erlendrm/LightBlu/Firmware/readme.txt

LDF1A_DK	- Bluetooth Smart Firmware for Kontrollmodul (nRF51 DK)
LDF1A_DONGLE	- Bluetooth Smart Firmware for Kontrollmodul (nRF51 Dongle)

LDFBIN1_MASTER	- Firmware for Switchmodul
LDFBIN1_SLAVE	- Firmware for Binaermodul

LDFDIM1_SLAVE	- Firmware for Dimmermodul
