erlendrm/LightBlu/Hardware/Utlegg/Binaermodul v.2.0.png

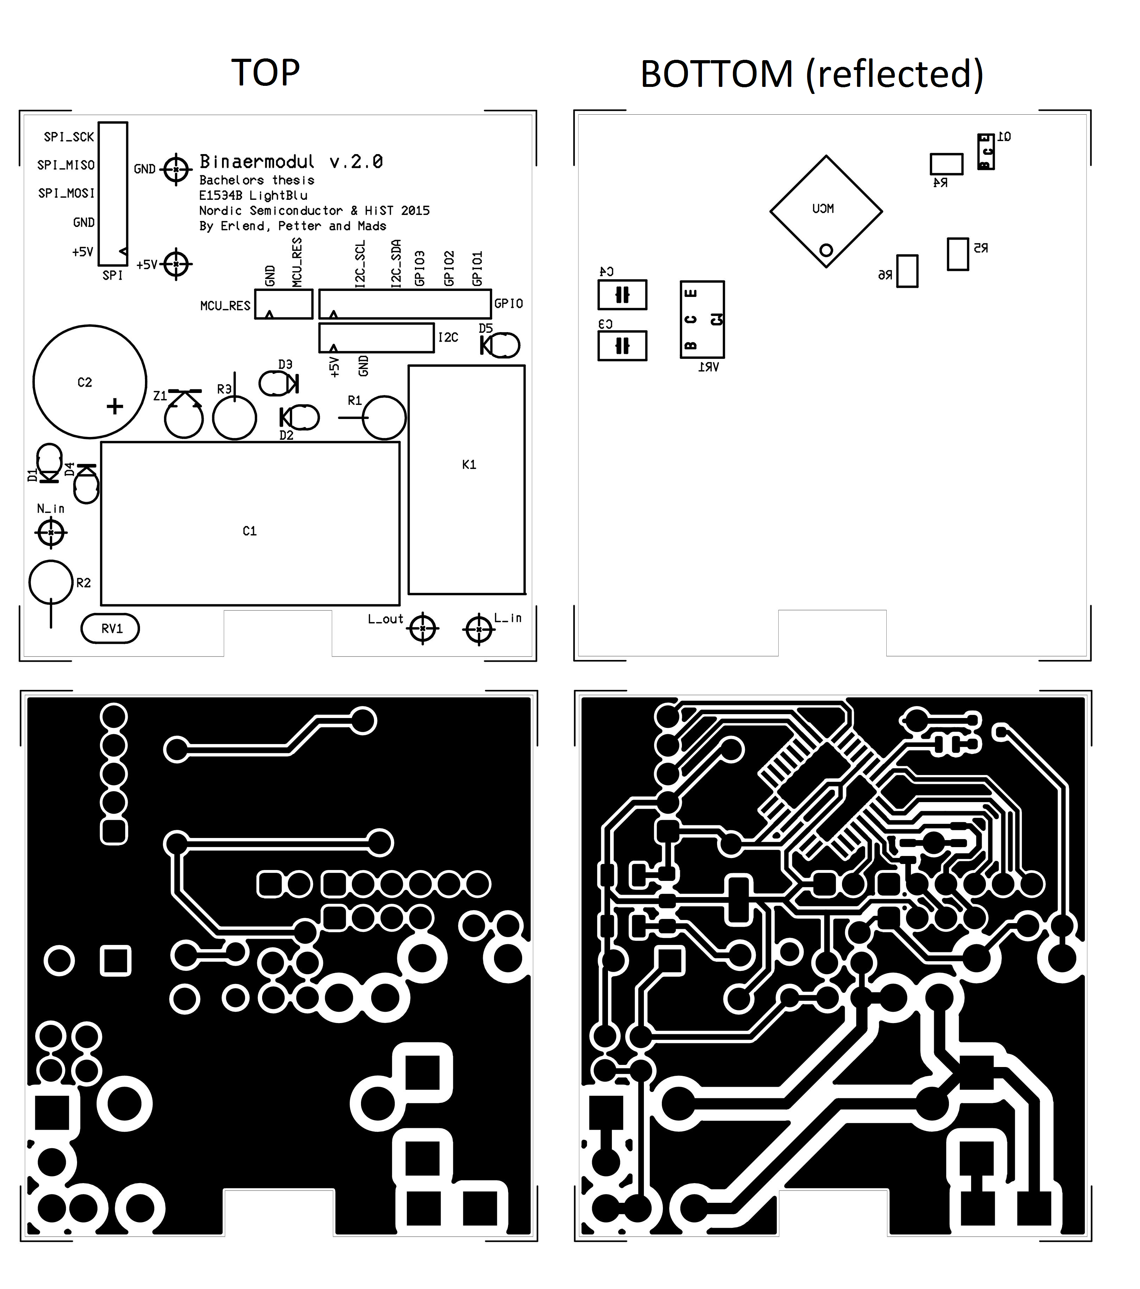
Hardware/Utlegg/Binaermodul v.2.0.png
