erlendrm/LightBlu/Hardware/Utlegg/Dimmermodul v.2.2.png

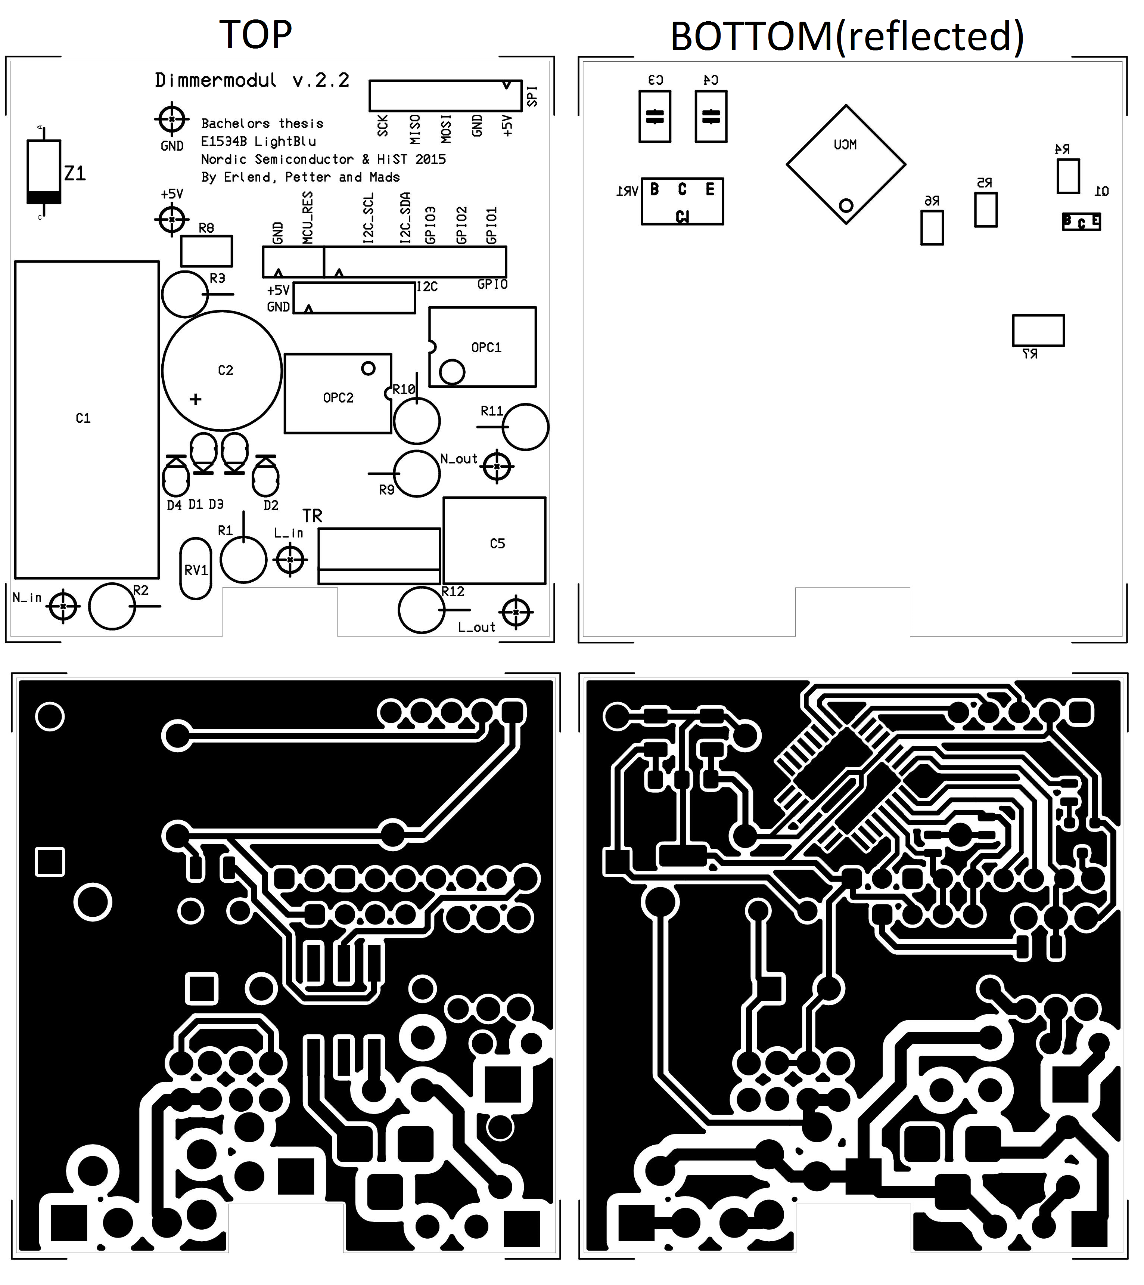
Hardware/Utlegg/Dimmermodul v.2.2.png
