erlendrm/LightBlu/Hardware/Skjemategninger/Binaermodul.pdf

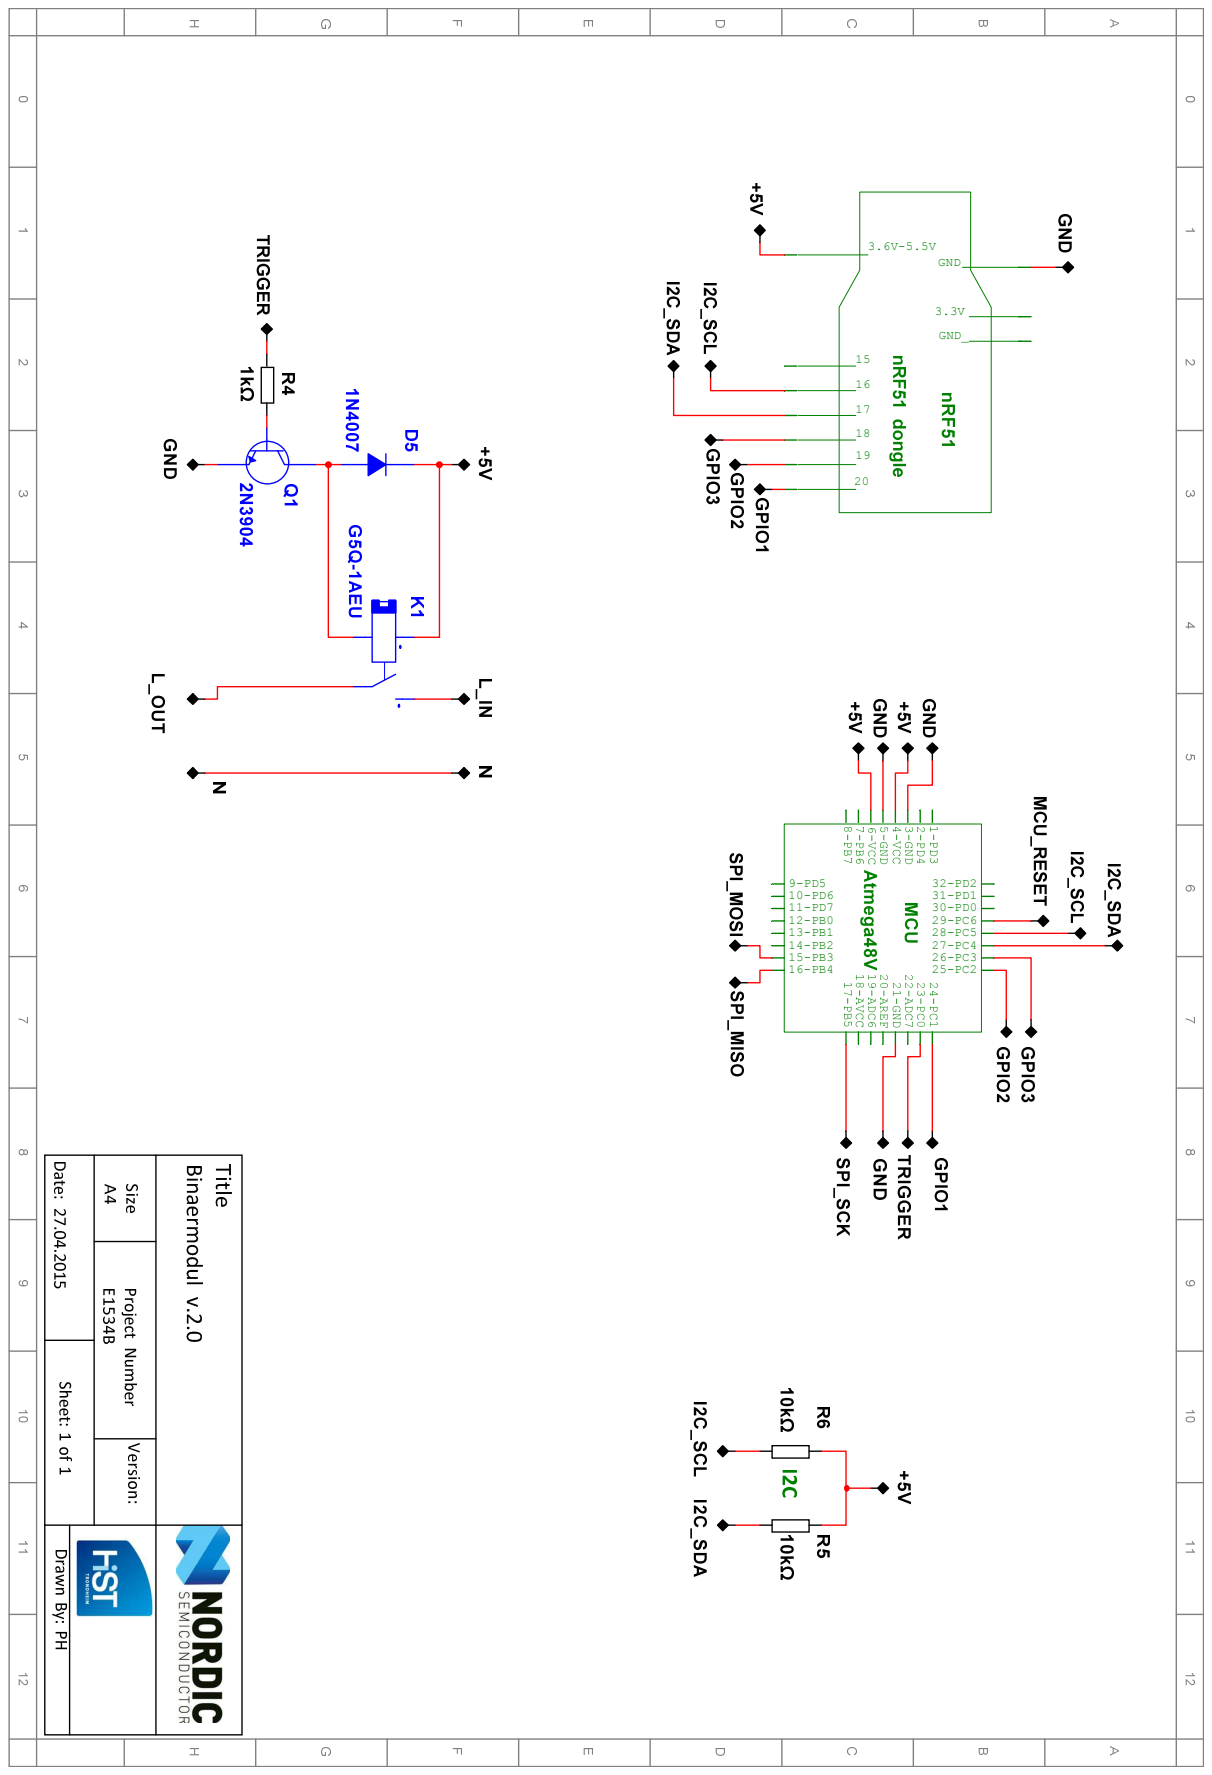
[picture p7: page 1]
GND; GND_
