erlendrm/LightBlu/Hardware/Skjemategninger/Dimmermod simplified.pdf

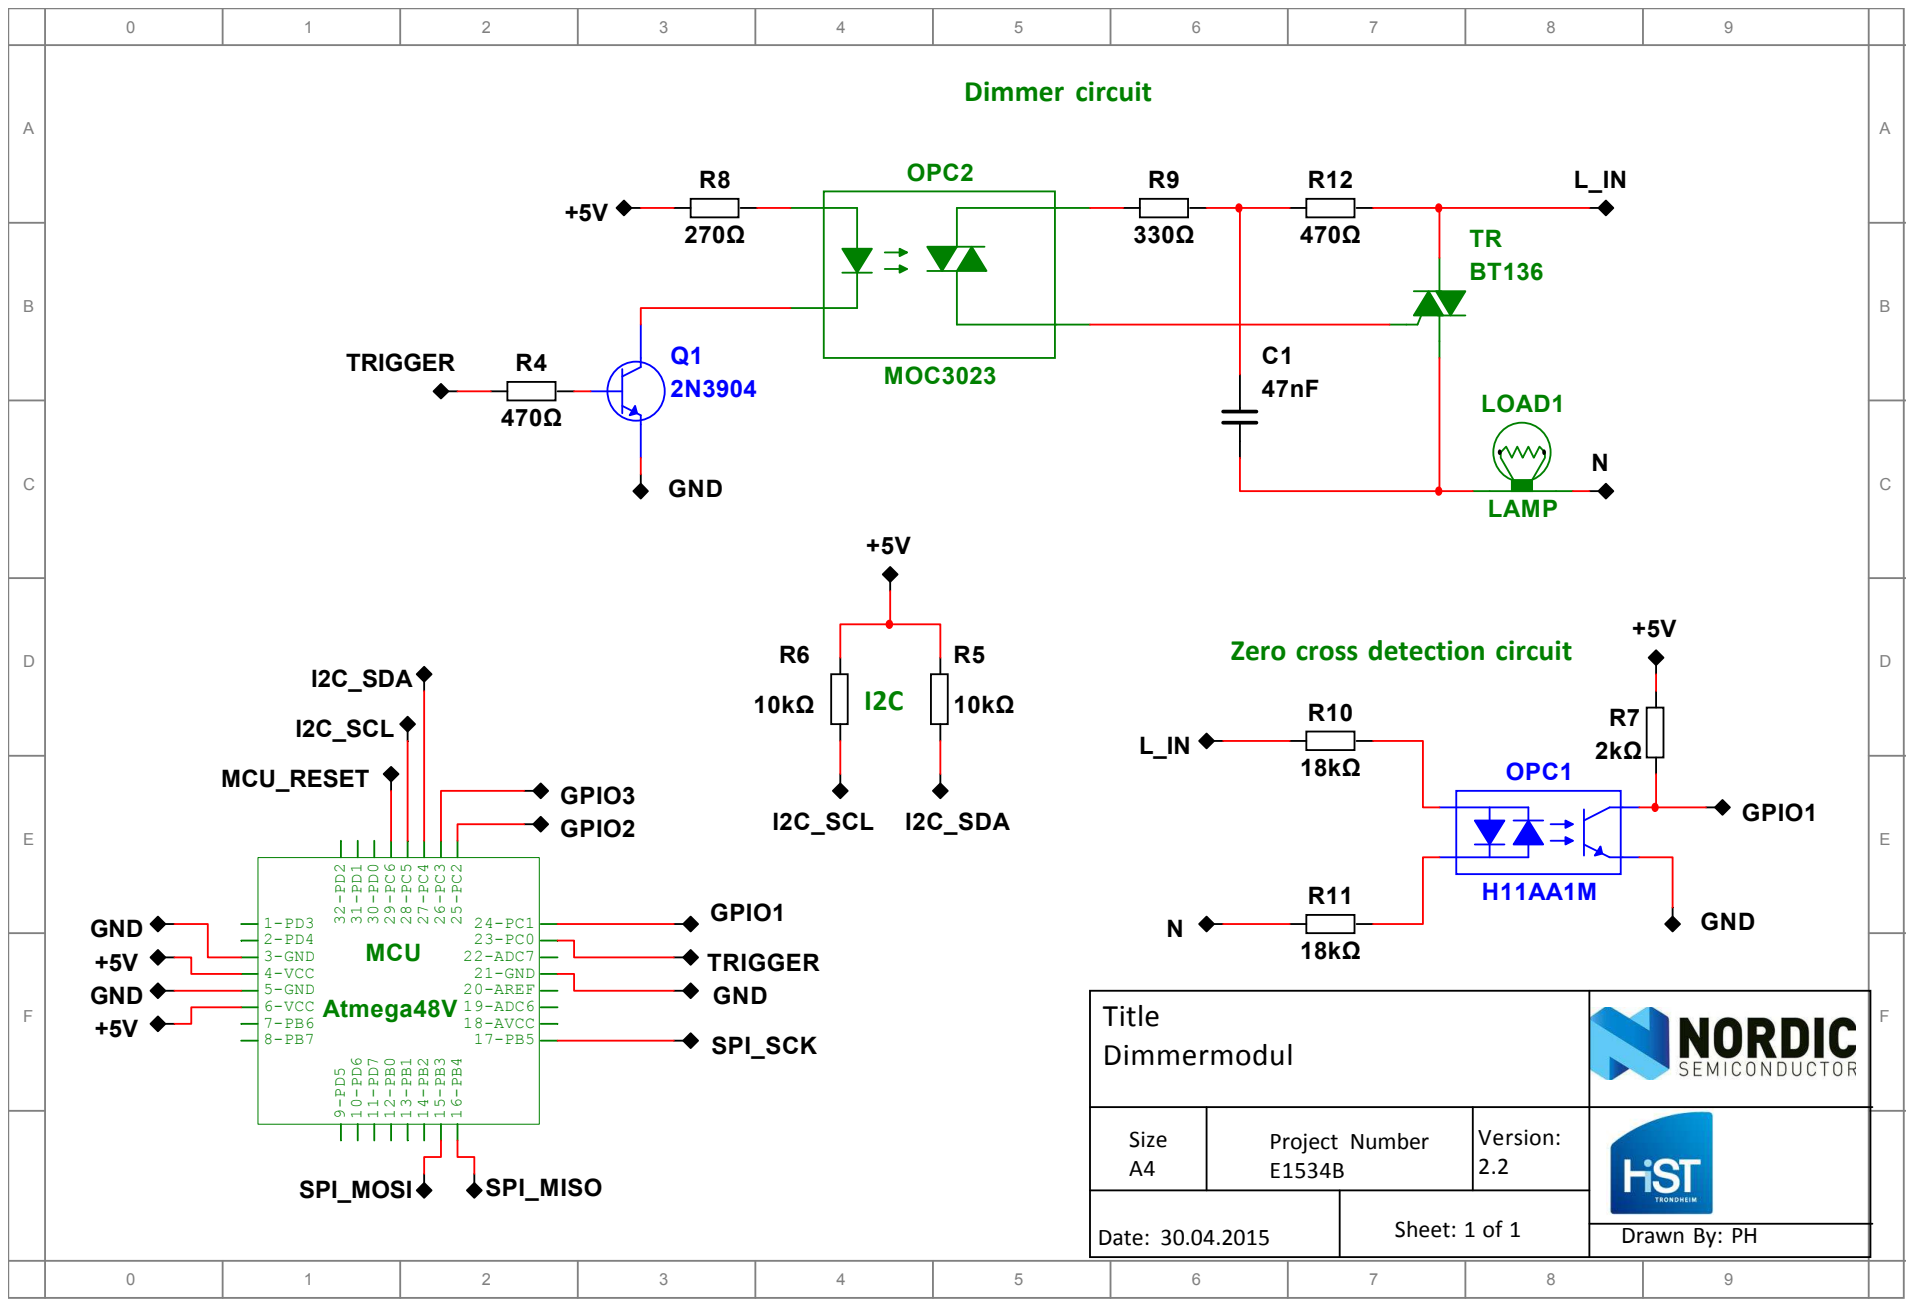
[picture p8: page 1]

Zero cross detection circuit
