erlendrm/LightBlu/Hardware/Skjemategninger/Dimmermodul.pdf

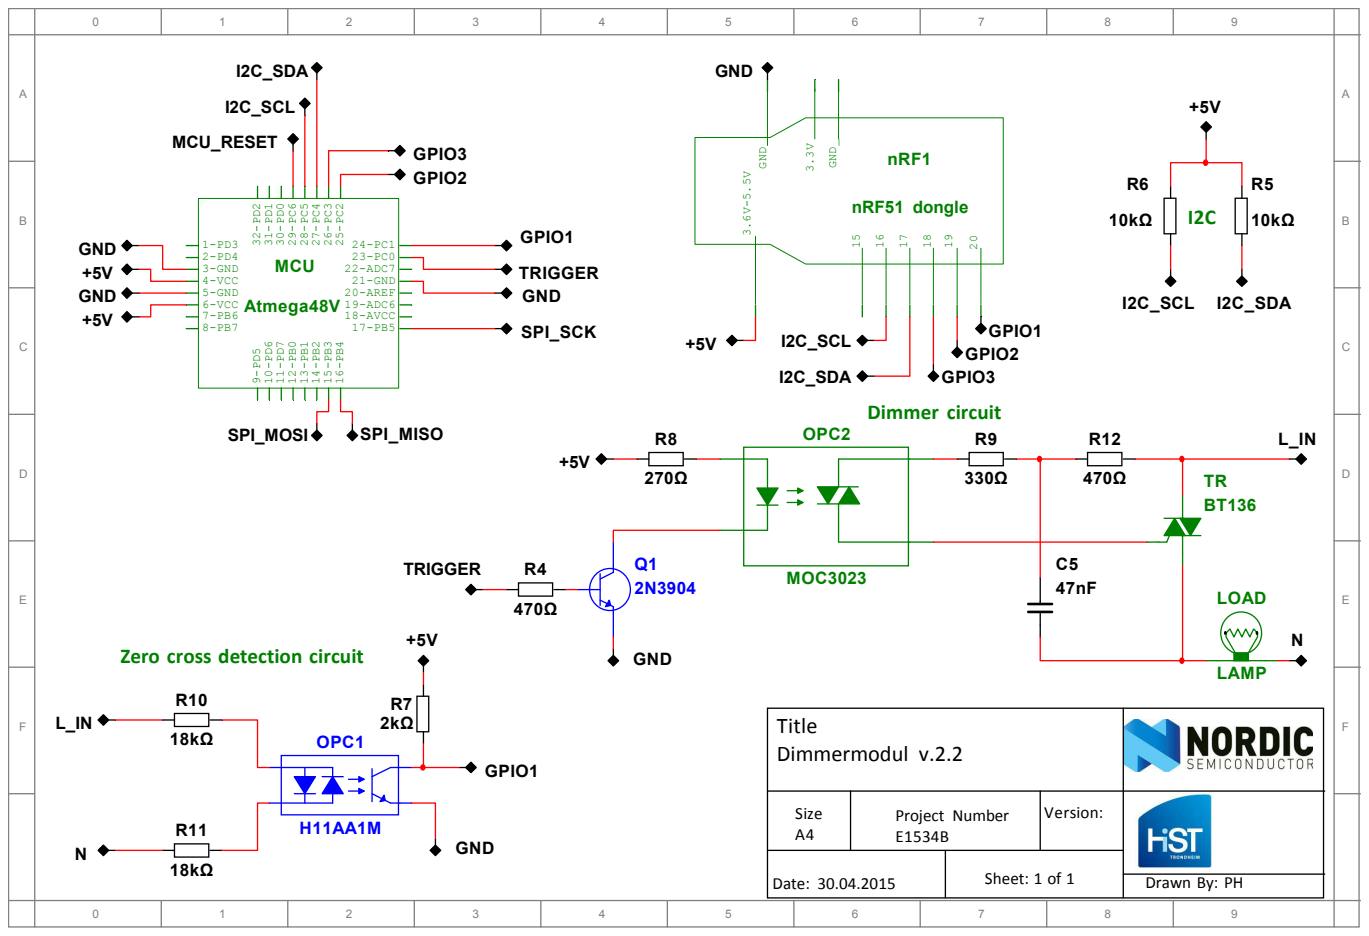
[picture p9: page 1]

Zero cross detection circuit
