erlendrm/LightBlu/Hardware/Skjemategninger/Binaermodul Simplified.pdf

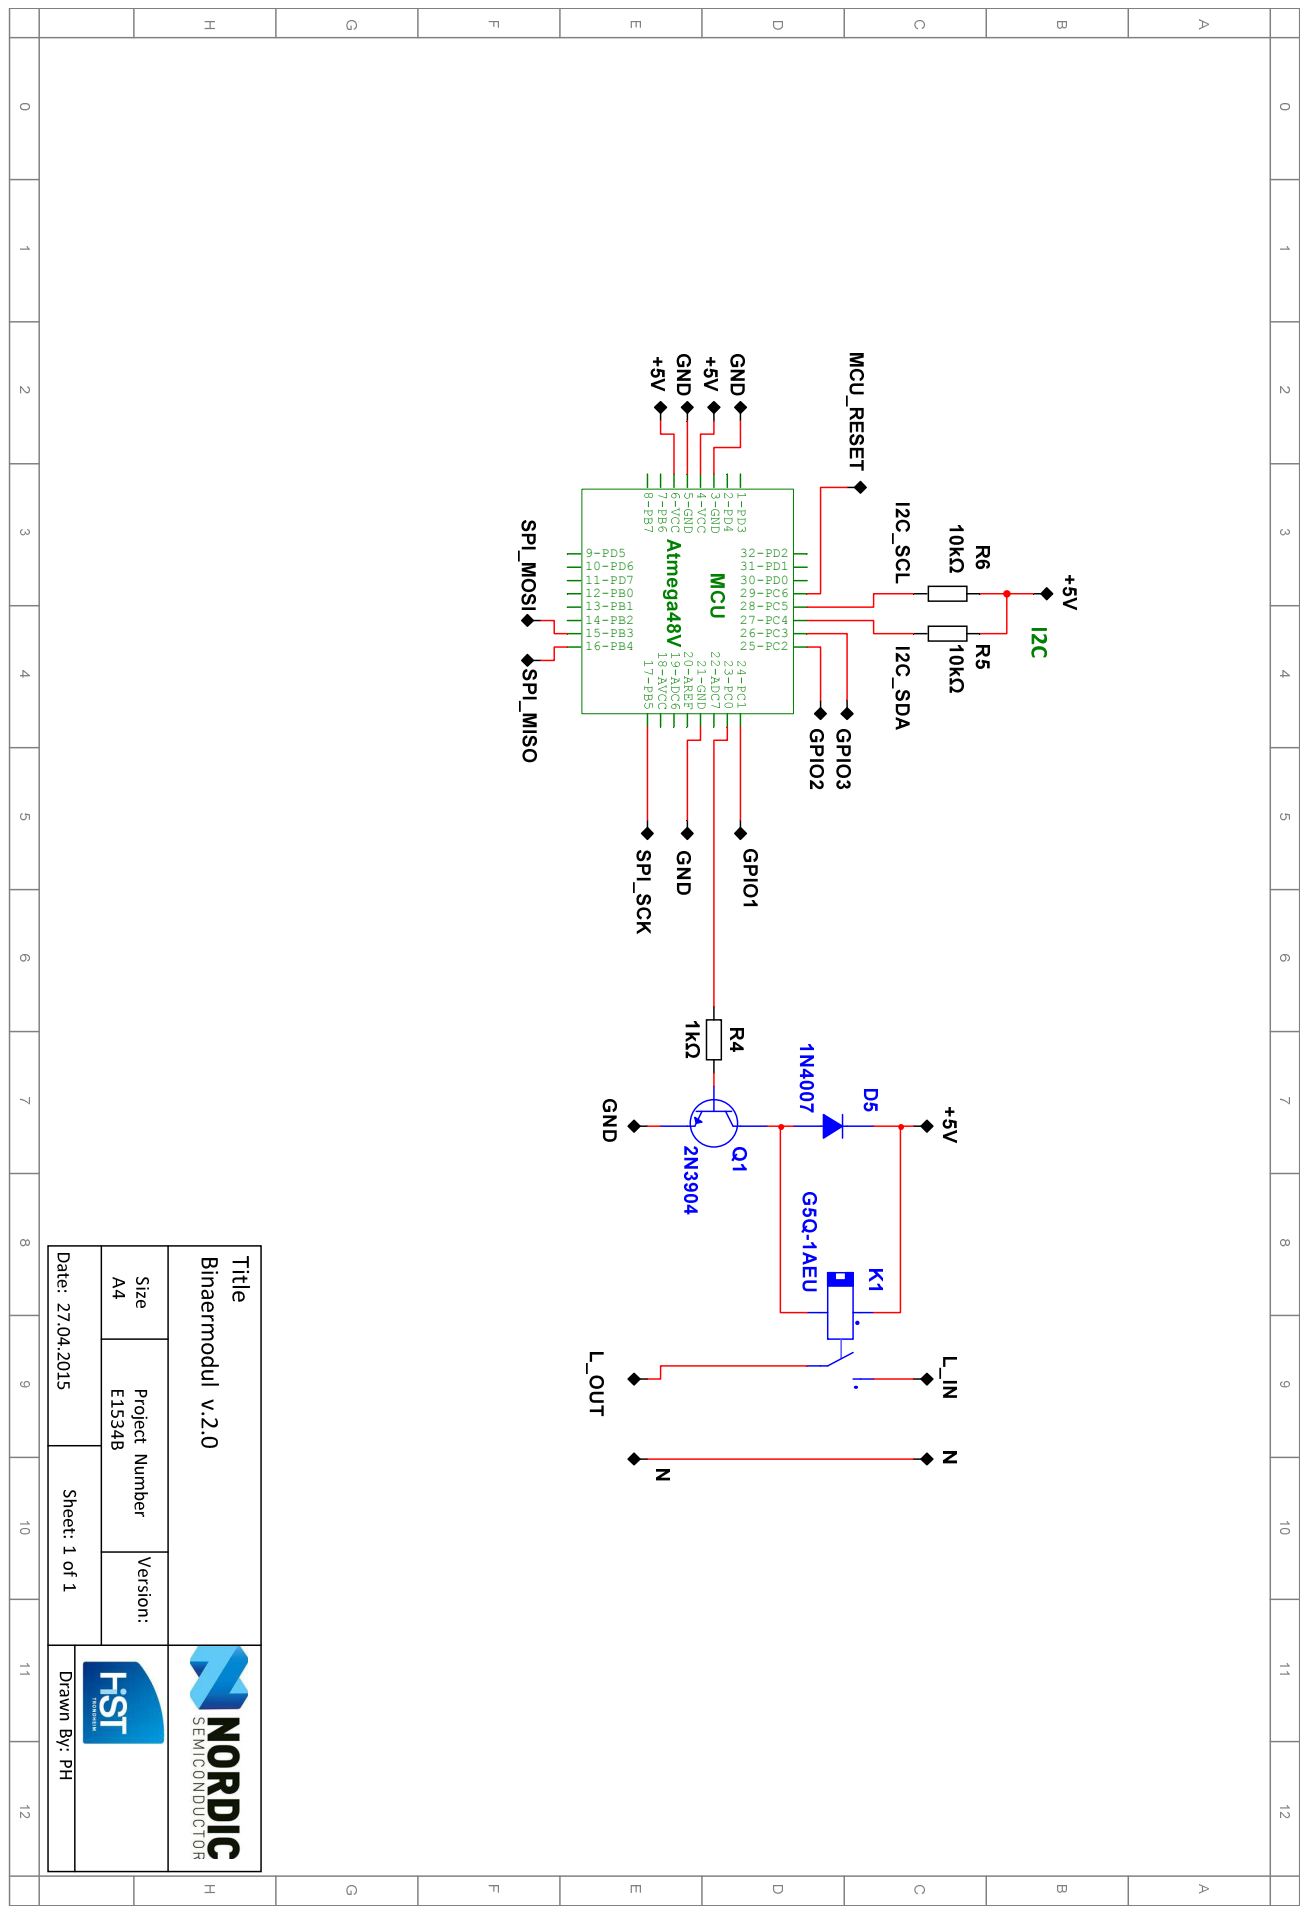
[picture p10: page 1]
