erlendrm/LightBlu/Hardware/Skjemategninger/VCC-Supply.pdf

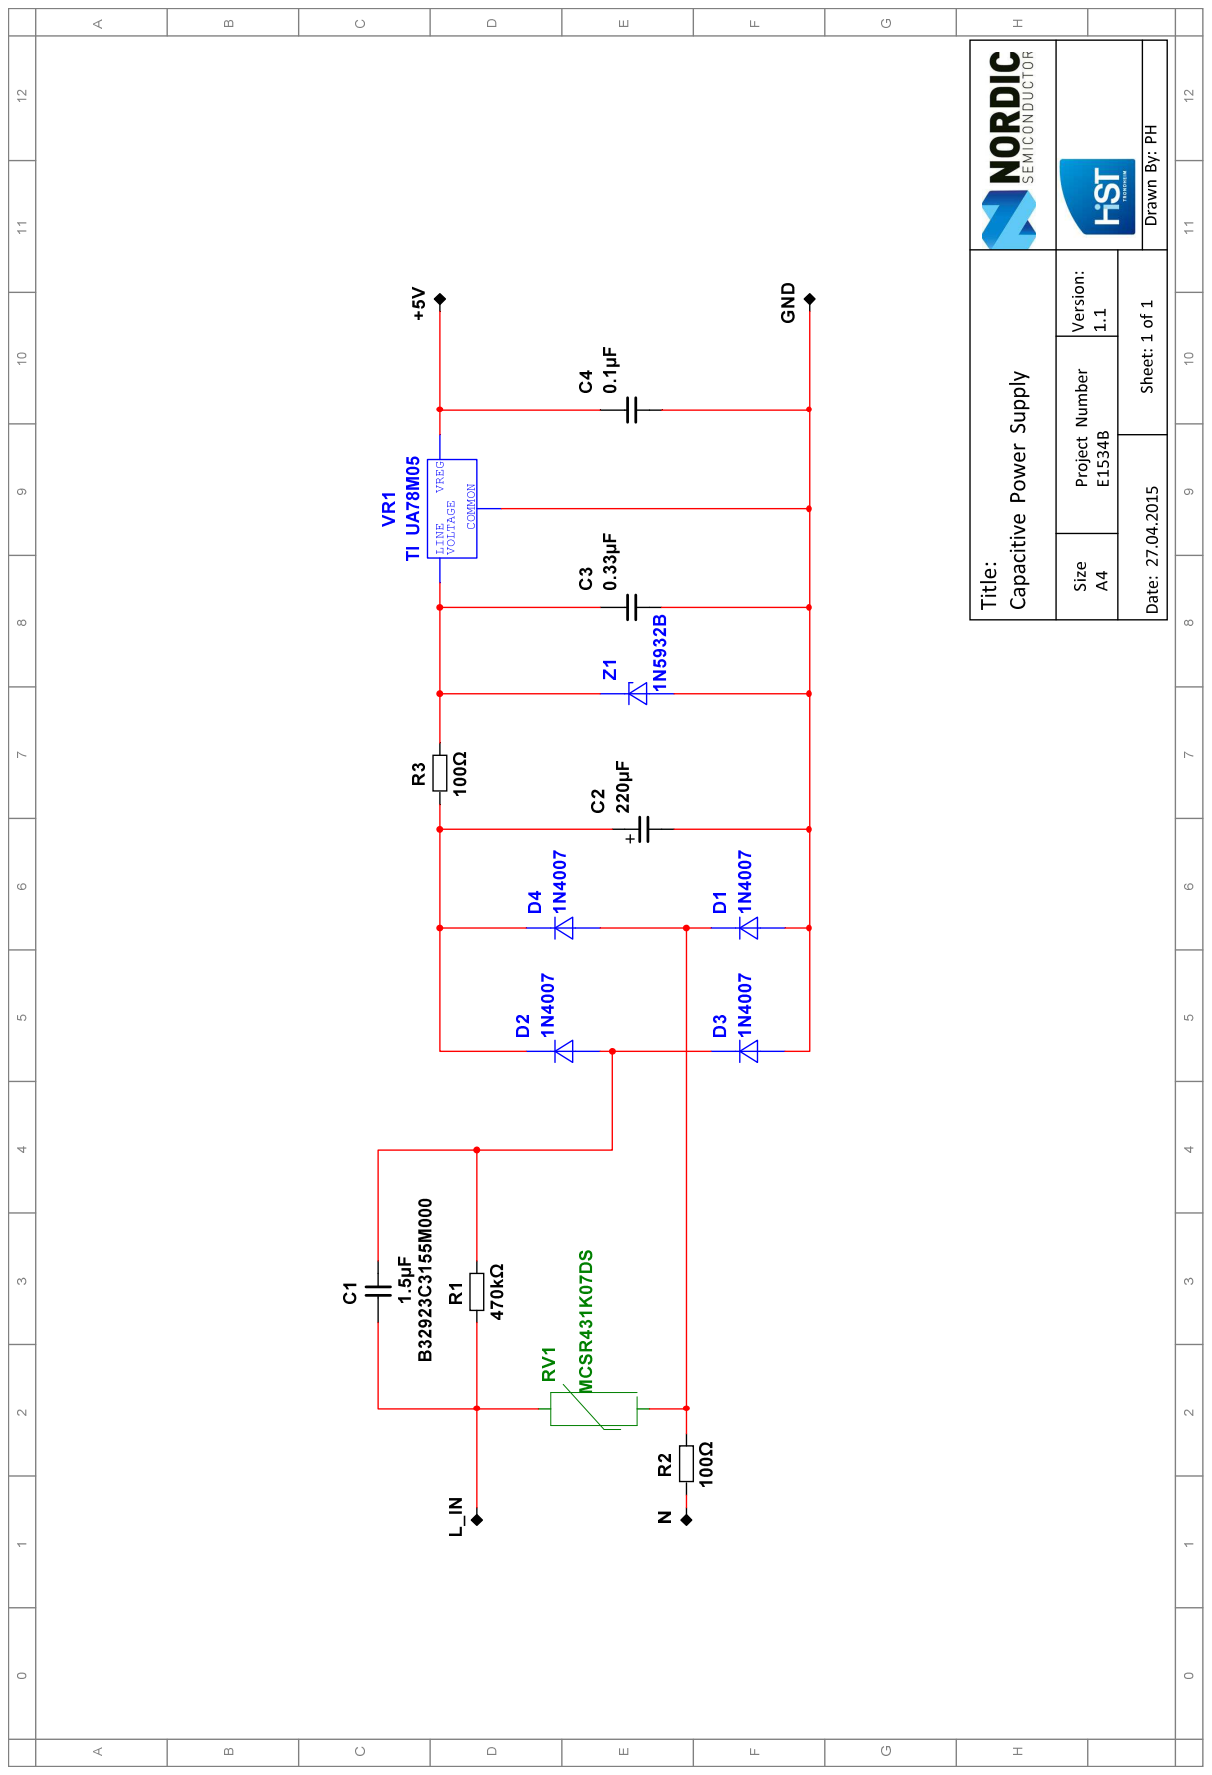
[picture p11: page 1]
