erlendrm/LightBlu/(list of files, drawings)

Other design files:
Hardware/Simuleringsfiler/DC-forsyning.ms13
Hardware/Simuleringsfiler/Dimmer for simulation.ms13
Hardware/Simuleringsfiler/Triac-trigging.ms13
Hardware/Simuleringsfiler/Zero-Cross.ms13
Hardware/Skjemategninger/Binaermodul Simplified.ms13
Hardware/Skjemategninger/Binaermodul.ms13
Hardware/Skjemategninger/Dimmermod simplified.ms13
Hardware/Skjemategninger/Dimmermodul.ms13
Hardware/Skjemategninger/VCC-Supply.ms13
