erlendrm/LightBlu/Firmware/LDF1A/Dongle/LDF1A_v.0.3_Dongle.c

/* Copyright (c) 2014 Nordic Semiconductor. All Rights Reserved.
 *
 * The information contained herein is property of Nordic Semiconductor ASA.
 * Terms and conditions of usage are described in detail in NORDIC
 * SEMICONDUCTOR STANDARD SOFTWARE LICENSE AGREEMENT.
 *
 * Licensees are granted free, non-transferable use of the information. NO
 * WARRANTY of ANY KIND is provided. This heading must NOT be removed from
 * the file.
 *
 */

/** @file
 *
 * @defgroup ble_sdk_app_template_main main.c
 * @{
 * @ingroup ble_sdk_app_template
 * @brief Template project main file.
 *
 */

#include <stdint.h>
#include <string.h>
#include "nordic_common.h"
#include "nrf.h"
#include "nrf_delay.h"
#include "app_error.h"
#include "nrf_gpio.h"
#include "nrf51_bitfields.h"
#include "ble.h"
#include "ble_hci.h"
#include "ble_srv_common.h"
#include "ble_advdata.h"
#include "ble_conn_params.h"
#include "app_scheduler.h"
#include "softdevice_handler.h"
#include "app_timer_appsh.h"
#include "app_gpiote.h"
#include "bsp.h"
#include "twi_master.h"
#include "Light_Control.h"


#define IS_SRVC_CHANGED_CHARACT_PRESENT 0                                           /**< Include or not the service_changed characteristic. if not enabled, the server's database cannot be changed for the lifetime of the device*/

#define WAKEUP_BUTTON_ID                0                                           /**< Button used to wake up the application. */

#define DEVICE_NAME                     "DIMMER1_LightBlu"                          /**< Name of device. Will be included in the advertising data. */

#define APP_ADV_INTERVAL                96                                          /**< The advertising interval (in units of 0.625 ms. This value corresponds to 40 ms). */
#define APP_ADV_TIMEOUT_IN_SECONDS      0                             	            /**< The advertising timeout (in units of seconds). */

#define APP_TIMER_PRESCALER             0                                           /**< Value of the RTC1 PRESCALER register. */
#define APP_TIMER_MAX_TIMERS            (3 + BSP_APP_TIMERS_NUMBER)                 /**< Maximum number of simultaneously created timers. */
#define APP_TIMER_OP_QUEUE_SIZE         4                                           /**< Size of timer operation queues. */

#define TEST_TIMER_INTERVAL							APP_TIMER_TICKS(1000, APP_TIMER_PRESCALER)

#define MIN_CONN_INTERVAL               MSEC_TO_UNITS(500, UNIT_1_25_MS)            /**< Minimum acceptable connection interval (0.5 seconds). */
#define MAX_CONN_INTERVAL               MSEC_TO_UNITS(1000, UNIT_1_25_MS)           /**< Maximum acceptable connection interval (1 second). */
#define SLAVE_LATENCY                   0                                           /**< Slave latency. */
#define CONN_SUP_TIMEOUT                MSEC_TO_UNITS(4000, UNIT_10_MS)             /**< Connection supervisory timeout (4 seconds). */
#define FIRST_CONN_PARAMS_UPDATE_DELAY  APP_TIMER_TICKS(5000, APP_TIMER_PRESCALER)  /**< Time from initiating event (connect or start of notification) to first time sd_ble_gap_conn_param_update is called (5 seconds). */
#define NEXT_CONN_PARAMS_UPDATE_DELAY   APP_TIMER_TICKS(30000, APP_TIMER_PRESCALER) /**< Time between each call to sd_ble_gap_conn_param_update after the first call (30 seconds). */
#define MAX_CONN_PARAMS_UPDATE_COUNT    3                                           /**< Number of attempts before giving up the connection parameter negotiation. */

#define APP_GPIOTE_MAX_USERS            1                                           /**< Maximum number of users of the GPIOTE handler. */

#define BUTTON_DETECTION_DELAY          APP_TIMER_TICKS(50, APP_TIMER_PRESCALER)    /**< Delay from a GPIOTE event until a button is reported as pushed (in number of timer ticks). */

#define SEC_PARAM_BOND                  1                                           /**< Perform bonding. */
#define SEC_PARAM_MITM                  0                                           /**< Man In The Middle protection not required. */
#define SEC_PARAM_IO_CAPABILITIES       BLE_GAP_IO_CAPS_NONE                        /**< No I/O capabilities. */
#define SEC_PARAM_OOB                   0                                           /**< Out Of Band data not available. */
#define SEC_PARAM_MIN_KEY_SIZE          7                                           /**< Minimum encryption key size. */
#define SEC_PARAM_MAX_KEY_SIZE          16                                          /**< Maximum encryption key size. */

#define BLE_UUID_LIGHT_CONTROL_SERVICE_H	0x2f160000e5dc11e4
#define BLE_UUID_LIGHT_CONTROL_SERVICE_L	0x9cf70002a5d5c51b
#define BLE_UUID_LIGHT_CONTROL_SHORT			0x0001
#define BLE_UUID_LIGHT_CMD_SHORT					0x0002
#define BLE_UUID_LIGHT_STATUS_SHORT				0x0003

#define DEAD_BEEF                       0xDEADBEEF                                  /**< Value used as error code on stack dump, can be used to identify stack location on stack unwind. */

static ble_lc_t													m_lc;
static ble_gap_sec_params_t             m_sec_params;                               /**< Security requirements for this application. */
static uint16_t                         m_conn_handle = BLE_CONN_HANDLE_INVALID;    /**< Handle of the current connection. */

static app_timer_id_t										m_test_timer_id;

#define SCHED_MAX_EVENT_DATA_SIZE       sizeof(app_timer_event_t)                   /**< Maximum size of scheduler events. Note that scheduler BLE stack events do not contain any data, as the events are being pulled from the stack in the event handler. */
#define SCHED_QUEUE_SIZE                10                                          /**< Maximum number of events in the scheduler queue. */

static void advertising_init(uint8_t data);

uint8_t 			global_data;
uint8_t 			ble_uuid_type_light_control_service;

uint8_t sla_r = (0x0A<<1)|(TWI_READ_BIT);
uint8_t sla_w = (0x0A<<1);


/**@brief Callback function for asserts in the SoftDevice.
 *
 * @details This function will be called in case of an assert in the SoftDevice.
 *
 * @warning This handler is an example only and does not fit a final product. You need to analyze
 *          how your product is supposed to react in case of Assert.
 * @warning On assert from the SoftDevice, the system can only recover on reset.
 *
 * @param[in]   line_num   Line number of the failing ASSERT call.
 * @param[in]   file_name  File name of the failing ASSERT call.
 */
void assert_nrf_callback(uint16_t line_num, const uint8_t * p_file_name)
{
    app_error_handler(DEAD_BEEF, line_num, p_file_name);
}


// Function for updating manufacturer. Called from timer_timeout_handler on timer timeout
static void manuf_data_update(void)
{
	
		if (twi_master_transfer(sla_r, &global_data, 1, TWI_ISSUE_STOP))
		{
				advertising_init(global_data);
		}
}

// Handler for timer timeout
static void timer_timeout_handler(void * p_context)
{
		UNUSED_PARAMETER(p_context);
		manuf_data_update();
}


// Handler for received Light Command on BLE event
static void lc_light_cmd_handler(ble_lc_t * p_lc, uint8_t * p_data, uint16_t length)
{
		if (length > 1)
		{
				return;
		}
		
		twi_master_transfer(sla_w, p_data, length, TWI_ISSUE_STOP);
		
}


// Handler for sending Light Status updates on Read Request
uint8_t lc_light_status_handler(void)
{
		uint8_t	read_data;
		
		twi_master_transfer(sla_r, &read_data, 1, TWI_ISSUE_STOP);
	
		return read_data;
}


/**@brief Function for the Timer initialization.
 *
 * @details Initializes the timer module.
 */
static void timers_init(void)
{
		uint32_t err_code;
	
		// Initialize timer module, making it use the scheduler
    APP_TIMER_APPSH_INIT(APP_TIMER_PRESCALER, APP_TIMER_MAX_TIMERS, APP_TIMER_OP_QUEUE_SIZE, true);
	
		err_code = app_timer_create(&m_test_timer_id, APP_TIMER_MODE_REPEATED, timer_timeout_handler);
		APP_ERROR_CHECK(err_code);
}


/**@brief Function for the GAP initialization.
 *
 * @details This function sets up all the necessary GAP (Generic Access Profile) parameters of the
 *          device including the device name, appearance, and the preferred connection parameters.
 */
static void gap_params_init(void)
{
    uint32_t                err_code;
    ble_gap_conn_params_t   gap_conn_params;
    ble_gap_conn_sec_mode_t sec_mode;

    BLE_GAP_CONN_SEC_MODE_SET_OPEN(&sec_mode);

    err_code = sd_ble_gap_device_name_set(&sec_mode,
                                          (const uint8_t *)DEVICE_NAME,
                                          strlen(DEVICE_NAME));
    APP_ERROR_CHECK(err_code);

    memset(&gap_conn_params, 0, sizeof(gap_conn_params));

    gap_conn_params.min_conn_interval = MIN_CONN_INTERVAL;
    gap_conn_params.max_conn_interval = MAX_CONN_INTERVAL;
    gap_conn_params.slave_latency     = SLAVE_LATENCY;
    gap_conn_params.conn_sup_timeout  = CONN_SUP_TIMEOUT;

    err_code = sd_ble_gap_ppcp_set(&gap_conn_params);
    APP_ERROR_CHECK(err_code);
}


/**@brief Function for initializing the Advertising functionality.
 *
 * @details Encodes the required advertising data and passes it to the stack.
 *          Also builds a structure to be passed to the stack when starting advertising.
 */
static void advertising_init(uint8_t data)
{
		uint32_t      err_code;
    ble_advdata_t advdata;
		ble_advdata_t scanrsp;
    uint8_t       flags = BLE_GAP_ADV_FLAGS_LE_ONLY_GENERAL_DISC_MODE;
	
    ble_uuid_t adv_uuids[] = {{BLE_UUID_LIGHT_CONTROL_SHORT, ble_uuid_type_light_control_service}};
		
		ble_advdata_manuf_data_t	manuf_data;
		manuf_data.company_identifier		= 0x59;
		manuf_data.data.p_data					= &data;
		manuf_data.data.size						= sizeof(data);

    // Build and set advertising data
    memset(&advdata, 0, sizeof(advdata));

    advdata.name_type               = BLE_ADVDATA_SHORT_NAME;
		advdata.short_name_len					= 7;
    advdata.include_appearance      = true;
    advdata.flags                   = flags;
		advdata.p_manuf_specific_data		= &manuf_data;
		
		// Build and set scan response
		memset(&scanrsp, 0, sizeof(scanrsp));
		
		scanrsp.uuids_complete.uuid_cnt = sizeof(adv_uuids) / sizeof(adv_uuids[0]);
    scanrsp.uuids_complete.p_uuids  = adv_uuids;

    err_code = ble_advdata_set(&advdata, &scanrsp);
    APP_ERROR_CHECK(err_code);
}


/**@brief Function for initializing services that will be used by the application.
 */
static void services_init(void)
{
    uint32_t			err_code;
		ble_lc_init_t	lc_init;
	
		// Setting up UUID's
		ble_uuid_t	uuid_light_control_service;		// UUID for Light Control Service 
		ble_uuid_t	uuid_light_status_char;				// UUID for Light Status Characteristic
		ble_uuid_t	uuid_light_cmd_char;					// UUID for Light Command Characteristic
	
		 
		uuid_light_control_service.type	= ble_uuid_type_light_control_service;
		uuid_light_control_service.uuid = BLE_UUID_LIGHT_CONTROL_SHORT;
	
		uuid_light_status_char.type	=	ble_uuid_type_light_control_service;
		uuid_light_status_char.uuid	= BLE_UUID_LIGHT_STATUS_SHORT;
	
		uuid_light_cmd_char.type	= ble_uuid_type_light_control_service;
		uuid_light_cmd_char.uuid	= BLE_UUID_LIGHT_CMD_SHORT;
	
		// Define handler for received Light Commands on BLE events
		lc_init.data_handler_cmd		= lc_light_cmd_handler;
		lc_init.data_handler_status = lc_light_status_handler;

		// Adding Light Control Service	
		err_code = ble_lc_init(&m_lc, 
													 &lc_init,
													 &uuid_light_control_service,
													 &uuid_light_status_char,
													 &uuid_light_cmd_char);
													 
		APP_ERROR_CHECK(err_code);
}


/**@brief Function for initializing security parameters.
 */
static void sec_params_init(void)
{
    m_sec_params.bond         = SEC_PARAM_BOND;
    m_sec_params.mitm         = SEC_PARAM_MITM;
    m_sec_params.io_caps      = SEC_PARAM_IO_CAPABILITIES;
    m_sec_params.oob          = SEC_PARAM_OOB;
    m_sec_params.min_key_size = SEC_PARAM_MIN_KEY_SIZE;
    m_sec_params.max_key_size = SEC_PARAM_MAX_KEY_SIZE;
}


/**@brief Function for handling the Connection Parameters Module.
 *
 * @details This function will be called for all events in the Connection Parameters Module which
 *          are passed to the application.
 *          @note All this function does is to disconnect. This could have been done by simply
 *                setting the disconnect_on_fail config parameter, but instead we use the event
 *                handler mechanism to demonstrate its use.
 *
 * @param[in]   p_evt   Event received from the Connection Parameters Module.
 */
static void on_conn_params_evt(ble_conn_params_evt_t * p_evt)
{
    uint32_t err_code;

    if(p_evt->evt_type == BLE_CONN_PARAMS_EVT_FAILED)
    {
        err_code = sd_ble_gap_disconnect(m_conn_handle, BLE_HCI_CONN_INTERVAL_UNACCEPTABLE);
        APP_ERROR_CHECK(err_code);
    }
}


/**@brief Function for handling a Connection Parameters error.
 *
 * @param[in]   nrf_error   Error code containing information about what went wrong.
 */
static void conn_params_error_handler(uint32_t nrf_error)
{
    APP_ERROR_HANDLER(nrf_error);
}


/**@brief Function for initializing the Connection Parameters module.
 */
static void conn_params_init(void)
{
    uint32_t               err_code;
    ble_conn_params_init_t cp_init;

    memset(&cp_init, 0, sizeof(cp_init));

    cp_init.p_conn_params                  = NULL;
    cp_init.first_conn_params_update_delay = FIRST_CONN_PARAMS_UPDATE_DELAY;
    cp_init.next_conn_params_update_delay  = NEXT_CONN_PARAMS_UPDATE_DELAY;
    cp_init.max_conn_params_update_count   = MAX_CONN_PARAMS_UPDATE_COUNT;
    cp_init.start_on_notify_cccd_handle    = BLE_GATT_HANDLE_INVALID;
    cp_init.disconnect_on_fail             = false;
    cp_init.evt_handler                    = on_conn_params_evt;
    cp_init.error_handler                  = conn_params_error_handler;

    err_code = ble_conn_params_init(&cp_init);
    APP_ERROR_CHECK(err_code);
}


/**@brief Function for starting timers.
*/
static void timers_start(void)
{
    uint32_t err_code;

    err_code = app_timer_start(m_test_timer_id, TEST_TIMER_INTERVAL, NULL);
    APP_ERROR_CHECK(err_code);
}


/**@brief Function for starting advertising.
 */
static void advertising_start(void)
{
    uint32_t             err_code;
    ble_gap_adv_params_t adv_params;

    // Start advertising
    memset(&adv_params, 0, sizeof(adv_params));

    adv_params.type        = BLE_GAP_ADV_TYPE_ADV_IND;
    adv_params.p_peer_addr = NULL;
    adv_params.fp          = BLE_GAP_ADV_FP_ANY;
    adv_params.interval    = APP_ADV_INTERVAL;
    adv_params.timeout     = APP_ADV_TIMEOUT_IN_SECONDS;

    err_code = sd_ble_gap_adv_start(&adv_params);
    APP_ERROR_CHECK(err_code);
    err_code = bsp_indication_set(BSP_INDICATE_ADVERTISING);
    APP_ERROR_CHECK(err_code);
}


/**@brief Function for handling the Application's BLE Stack events.
 *
 * @param[in]   p_ble_evt   Bluetooth stack event.
 */
static void on_ble_evt(ble_evt_t * p_ble_evt)
{
    uint32_t                         err_code;
    static ble_gap_evt_auth_status_t m_auth_status;
    bool                             master_id_matches;
    ble_gap_sec_kdist_t *            p_distributed_keys;
    ble_gap_enc_info_t *             p_enc_info;
    ble_gap_irk_t *                  p_id_info;
    ble_gap_sign_info_t *            p_sign_info;

    static ble_gap_enc_key_t         m_enc_key;           /**< Encryption Key (Encryption Info and Master ID). */
    static ble_gap_id_key_t          m_id_key;            /**< Identity Key (IRK and address). */
    static ble_gap_sign_info_t       m_sign_key;          /**< Signing Key (Connection Signature Resolving Key). */
    static ble_gap_sec_keyset_t      m_keys = {.keys_periph = {&m_enc_key, &m_id_key, &m_sign_key}};

    switch (p_ble_evt->header.evt_id)
    {
        case BLE_GAP_EVT_CONNECTED:
						err_code = bsp_indication_set(BSP_INDICATE_CONNECTED);
            APP_ERROR_CHECK(err_code);
            m_conn_handle = p_ble_evt->evt.gap_evt.conn_handle;
						
						app_timer_stop(m_test_timer_id);
            break;

        case BLE_GAP_EVT_DISCONNECTED:
            err_code = bsp_indication_set(BSP_INDICATE_IDLE);
            APP_ERROR_CHECK(err_code);
            m_conn_handle = BLE_CONN_HANDLE_INVALID;
            
						timers_start();
            advertising_start();
            break;

        case BLE_GAP_EVT_SEC_PARAMS_REQUEST:
            err_code = sd_ble_gap_sec_params_reply(m_conn_handle,
                                                   BLE_GAP_SEC_STATUS_SUCCESS,
                                                   &m_sec_params,
                                                   &m_keys);
            APP_ERROR_CHECK(err_code);
            break;

        case BLE_GATTS_EVT_SYS_ATTR_MISSING:
            err_code = sd_ble_gatts_sys_attr_set(m_conn_handle,
                                                 NULL,
                                                 0,
                                                 BLE_GATTS_SYS_ATTR_FLAG_SYS_SRVCS | BLE_GATTS_SYS_ATTR_FLAG_USR_SRVCS);
            APP_ERROR_CHECK(err_code);
            break;

        case BLE_GAP_EVT_AUTH_STATUS:
            m_auth_status = p_ble_evt->evt.gap_evt.params.auth_status;
            break;

        case BLE_GAP_EVT_SEC_INFO_REQUEST:
            master_id_matches  = memcmp(&p_ble_evt->evt.gap_evt.params.sec_info_request.master_id,
                                        &m_enc_key.master_id,
                                        sizeof(ble_gap_master_id_t)) == 0;
            p_distributed_keys = &m_auth_status.kdist_periph;

            p_enc_info  = (p_distributed_keys->enc  && master_id_matches) ? &m_enc_key.enc_info : NULL;
            p_id_info   = (p_distributed_keys->id   && master_id_matches) ? &m_id_key.id_info   : NULL;
            p_sign_info = (p_distributed_keys->sign && master_id_matches) ? &m_sign_key         : NULL;

            err_code = sd_ble_gap_sec_info_reply(m_conn_handle, p_enc_info, p_id_info, p_sign_info);
            APP_ERROR_CHECK(err_code);
            break;

        case BLE_GAP_EVT_TIMEOUT:
            if (p_ble_evt->evt.gap_evt.params.timeout.src == BLE_GAP_TIMEOUT_SRC_ADVERTISING)
            {
                err_code = bsp_indication_set(BSP_INDICATE_IDLE);
                APP_ERROR_CHECK(err_code);
                // Configure buttons with sense level low as wakeup source.
                err_code = bsp_buttons_enable(1 << WAKEUP_BUTTON_ID);
                APP_ERROR_CHECK(err_code);
                // Go to system-off mode (this function will not return; wakeup will cause a reset)                
                err_code = sd_power_system_off();
                APP_ERROR_CHECK(err_code);
            }
            break;

        default:
            // No implementation needed.
            break;
    }
}


/**@brief Function for dispatching a BLE stack event to all modules with a BLE stack event handler.
 *
 * @details This function is called from the scheduler in the main loop after a BLE stack
 *          event has been received.
 *
 * @param[in]   p_ble_evt   Bluetooth stack event.
 */
static void ble_evt_dispatch(ble_evt_t * p_ble_evt)
{
    ble_conn_params_on_ble_evt(p_ble_evt);
		ble_lc_on_ble_event(&m_lc, p_ble_evt);
		on_ble_evt(p_ble_evt);
}


/**@brief Function for dispatching a system event to interested modules.
 *
 * @details This function is called from the System event interrupt handler after a system
 *          event has been received.
 *
 * @param[in]   sys_evt   System stack event.
 */
static void sys_evt_dispatch(uint32_t sys_evt)
{
    
}


/**@brief Function for initializing the BLE stack.
 *
 * @details Initializes the SoftDevice and the BLE event interrupt.
 */
static void ble_stack_init(void)
{
    uint32_t err_code;

    // Initialize the SoftDevice handler module.
    SOFTDEVICE_HANDLER_INIT(NRF_CLOCK_LFCLKSRC_XTAL_20_PPM, NULL);

#ifdef S110
    // Enable BLE stack 
    ble_enable_params_t ble_enable_params;
    memset(&ble_enable_params, 0, sizeof(ble_enable_params));
    ble_enable_params.gatts_enable_params.service_changed = IS_SRVC_CHANGED_CHARACT_PRESENT;
    err_code = sd_ble_enable(&ble_enable_params);
    APP_ERROR_CHECK(err_code);
#endif
    
    // Register with the SoftDevice handler module for BLE events.
    err_code = softdevice_ble_evt_handler_set(ble_evt_dispatch);
    APP_ERROR_CHECK(err_code);
    
    // Register with the SoftDevice handler module for BLE events.
    err_code = softdevice_sys_evt_handler_set(sys_evt_dispatch);
    APP_ERROR_CHECK(err_code);
}


/**@brief Function for the Event Scheduler initialization.
 */
static void scheduler_init(void)
{
    APP_SCHED_INIT(SCHED_MAX_EVENT_DATA_SIZE, SCHED_QUEUE_SIZE);
}


/**@brief Function for initializing the GPIOTE handler module.
 */
static void gpiote_init(void)
{
    APP_GPIOTE_INIT(APP_GPIOTE_MAX_USERS);
}


/**@brief Function for initializing the button handler module.
 */
static void buttons_init(void)
{   
        uint32_t err_code;
	
        err_code = bsp_buttons_enable(1 << WAKEUP_BUTTON_ID);
        APP_ERROR_CHECK(err_code);
}


/**@brief Function for the Power manager.
 */
static void power_manage(void)
{
    uint32_t err_code = sd_app_evt_wait();
    APP_ERROR_CHECK(err_code);
}


/**@brief Function for initializing bsp module.
 */
static void bsp_module_init(void)
{
        uint32_t err_code;
        
        err_code = bsp_init(BSP_INIT_LED | BSP_INIT_BUTTONS, APP_TIMER_TICKS(100, APP_TIMER_PRESCALER), NULL);
        APP_ERROR_CHECK(err_code);
        
        buttons_init();
}


static void custom_uuid_init(void)
{
	uint32_t			err_code;
	
	uint64_t			uuid_high			= BLE_UUID_LIGHT_CONTROL_SERVICE_H;
	uint64_t			uuid_low			= BLE_UUID_LIGHT_CONTROL_SERVICE_L;
	
	ble_uuid128_t	ble_uuid_light_control_service;
	uint64_t			temp_64bit;
	uint8_t				temp_8bit;
	uint8_t				i;
	
	for (i=0; i<sizeof(uuid_low); i++)
	{
		temp_64bit = ((uuid_low >> (8*i)) & 0xff);
		temp_8bit = temp_64bit;
		
		ble_uuid_light_control_service.uuid128[i] = temp_8bit;
		temp_64bit = 0;
		temp_8bit  = 0;
	}
	
	for (i=0; i<sizeof(uuid_high); i++)
	{
		temp_64bit = ((uuid_high >> (8*i)) & 0xff);
		temp_8bit = temp_64bit;
		
		ble_uuid_light_control_service.uuid128[(i+8)] = temp_8bit;
		temp_64bit = 0;
		temp_8bit  = 0;
	}
	
	 err_code = sd_ble_uuid_vs_add(&ble_uuid_light_control_service,&ble_uuid_type_light_control_service);
   APP_ERROR_CHECK(err_code);
	
}

/**@brief Function for application main entry.
 */
int main(void)
{
    global_data = 0x00;
	
		// Initialize
	
		nrf_delay_ms(2500);
	
		twi_master_init();
	
    timers_init();
    gpiote_init();
    ble_stack_init();
    bsp_module_init();
    scheduler_init();
    gap_params_init();
		custom_uuid_init();
    advertising_init(global_data);
    services_init();
    conn_params_init();
    sec_params_init();

    // Start execution
    timers_start();
    advertising_start();

    // Enter main loop
    for (;;)
    {
        app_sched_execute();
        power_manage();
    }
}

/**
 * @}
 */
