erlendrm/LightBlu/Firmware/LDFBIN1/LDFBIN1_SLAVE/config.h

/*
 * config.h
 *
 * Created: 19.05.2015 20:55:01
 *  Author: Erlend
 */ 


#ifndef CONFIG_H_
#define CONFIG_H_

#define TWI_ADDR_SWITCH		0b0001001	// TWI address for SWITCH
#define TWI_ADDR_MODUL		0b0001010	// TWI address for BINAERMODUL


#endif /* CONFIG_H_ */
